Aifryz/usb-pedal/hardware/mini-pill/mini-pill.pdf

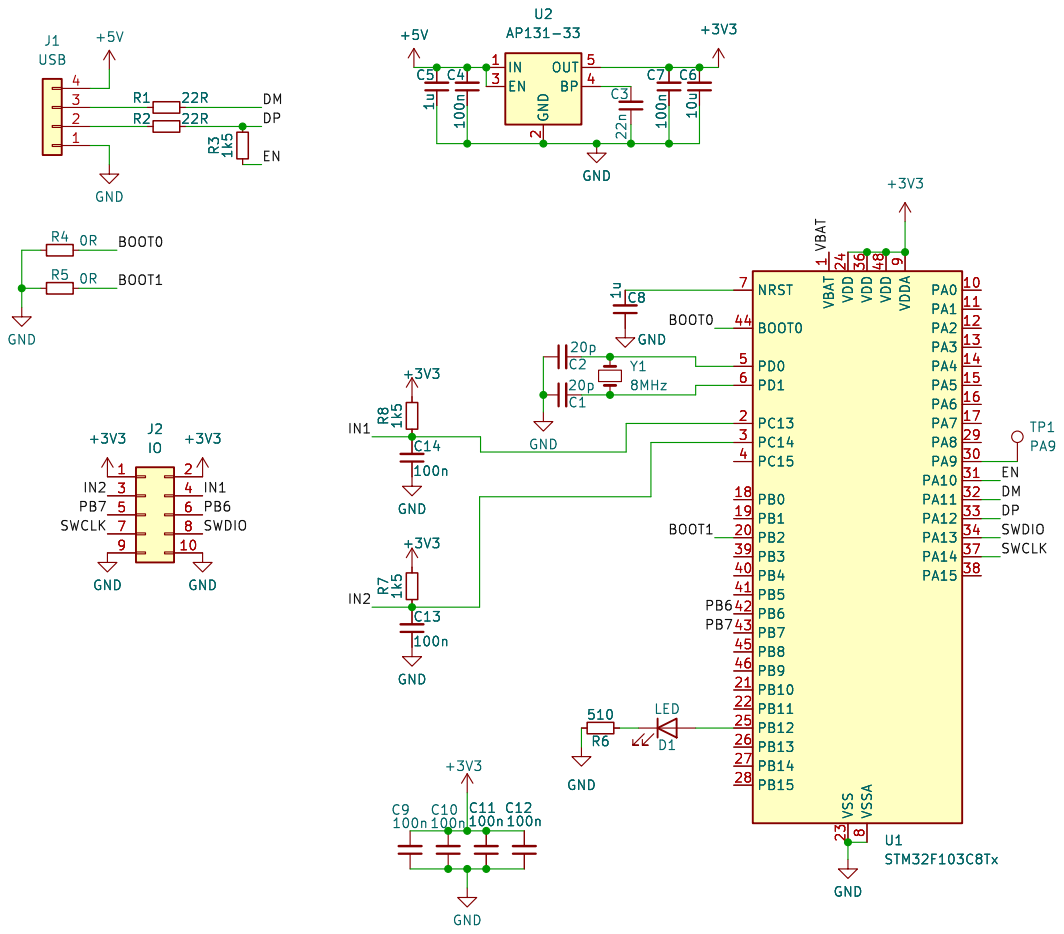
[picture p1: page 1]

Id: 1/1 Title: File: mini-pill.kicad_sch Sheet: / GND GND
