Aifryz/usb-pedal/hardware/mini-pill/mini-pill.kicad_pcb

## KiCad design hardware/mini-pill/mini-pill.kicad_pcb (2023-10-14)

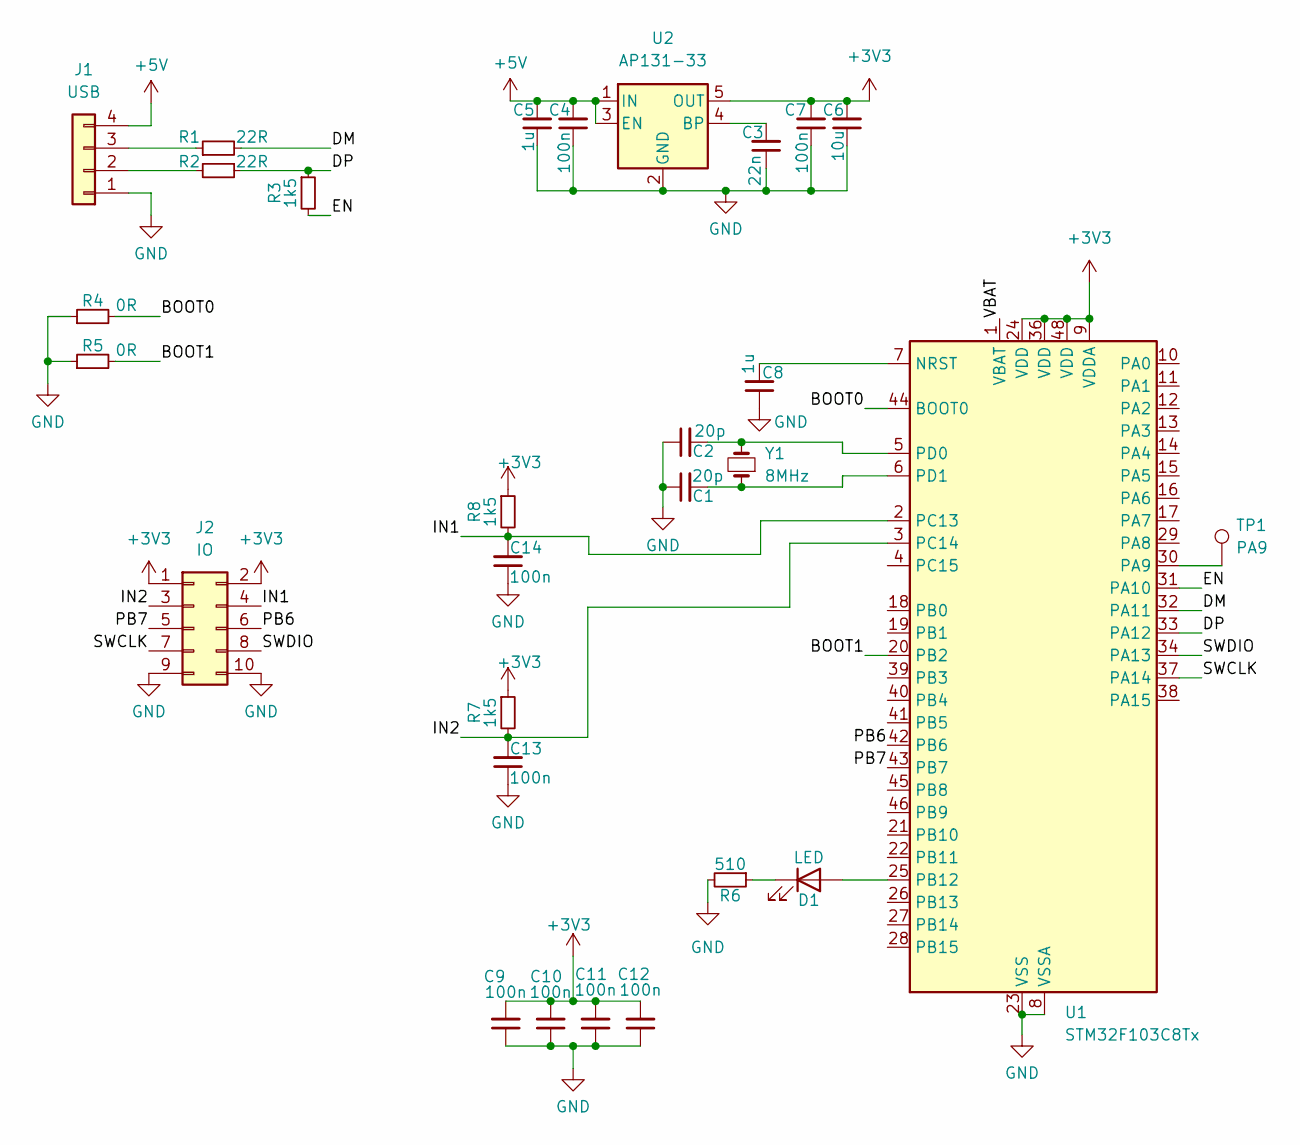
[picture p2: schematic mini-pill.kicad_sch]

Parts:
C1, C2: 20p; C_0603_1608Metric
C3: 22n; C_0603_1608Metric
C4, C7, C9, C10, C11, C12, C13, C14: 100n; C_0603_1608Metric
C5, C8: 1u; C_0603_1608Metric
C6: 10u; C_0805_2012Metric
D1: LED; LED_0805_2012Metric
J1: USB; PinSocket_1x04_P2.00mm_Vertical
J2: IO; PinHeader_2x05_P2.54mm_Vertical
R1, R2: 22R; R_0603_1608Metric
R3, R7, R8: 1k5; R_0603_1608Metric
R4, R5: 0R; R_0603_1608Metric
R6: 510; R_0603_1608Metric
TP1: PA9; TestPoint_Pad_D1.0mm
U1: STM32F103C8Tx; LQFP-48_7x7mm_P0.5mm
U2: AP131-33; SOT-23-5
Y1: 8MHz; Crystal_HC18-U_Vertical

Connections:
+3V3: C6.2, C7.2, C9.2, C10.2, C11.2, C12.2, J2.1, J2.2, R7.1, R8.1, U1.9 (VDDA), U1.24 (VDD), U1.36 (VDD), U1.48 (VDD), U2.5 (OUT)
+5V: C4.2, C5.2, J1.4, U2.1 (IN), U2.3 (EN)
/BOOT0: R4.2, U1.44 (BOOT0)
/BOOT1: R5.2, U1.20 (PB2)
/DM: R1.2, U1.32 (PA11)
/DP: R2.1, R3.1, U1.33 (PA12)
/EN: R3.2, U1.31 (PA10)
/IN1: C14.2, J2.4, R8.2, U1.2 (PC13)
/IN2: C13.2, J2.3, R7.2, U1.3 (PC14)
/PB6: J2.6, U1.42 (PB6)
/PB7: J2.5, U1.43 (PB7)
/SWCLK: J2.7, U1.37 (PA14)
/SWDIO: J2.8, U1.34 (PA13)
/VBAT: U1.1 (VBAT)
GND: C1.1, C2.1, C3.1, C4.1, C5.1, C6.1, C7.1, C8.1, C9.1, C10.1, C11.1, C12.1, C13.1, C14.1, J1.1, J2.9, J2.10, R4.1, R5.1, R6.2, U1.8 (VSSA), U1.23 (VSS), U1.35 (VSS), U1.47 (VSS), U2.2 (GND)
unnamed: D1.2 (A), U1.25 (PB12)
unnamed: D1.1 (K), R6.1
unnamed: J1.2, R2.2
unnamed: J1.3, R1.1
unnamed: C8.2, U1.7 (NRST)
unnamed: TP1.1, U1.30 (PA9)
unnamed: C2.2, U1.5 (PD0), Y1.2
unnamed: C1.2, U1.6 (PD1), Y1.1
unnamed: C3.2, U2.4 (BP)

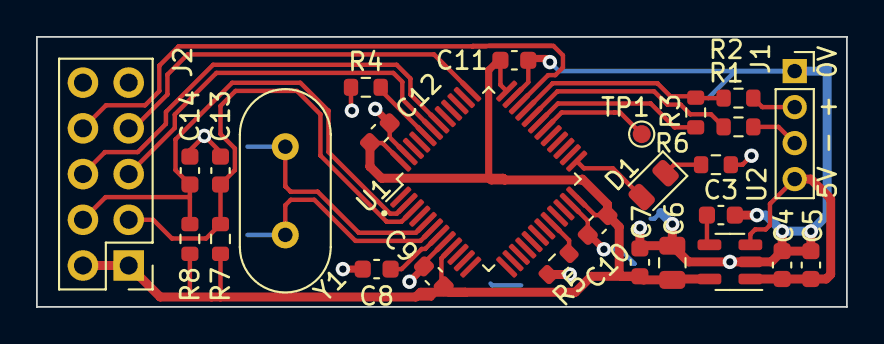
[picture p3: board mini-pill.kicad_pcb from above]

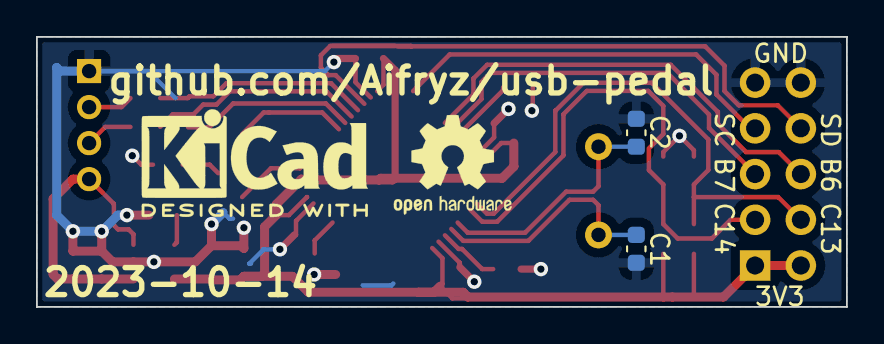
[picture p4: board mini-pill.kicad_pcb from below]

Board: 2 copper layers, 45.0 x 15.0 mm, 29 parts (2 on the bottom side), 23 nets.
