Aifryz/usb-pedal/firmware/usb-pedal/Core/Src/main.c

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
/* Includes ------------------------------------------------------------------*/
#include "main.h"
#include "usb_device.h"

/* USER CODE BEGIN Includes */
#include "usbd_hid.h"
/* USER CODE END Includes */


/* USER CODE BEGIN PV */

const uint8_t KEY_NONE = 0x00;
const uint8_t KEY_APOSTROPHE = 0x34; // Scancode for ' " key

uint8_t hid_report[8];

extern USBD_HandleTypeDef hUsbDeviceFS;
/* USER CODE END PV */

void SystemClock_Config(void);
static void MX_GPIO_Init(void);
/* USER CODE BEGIN PFP */
void MakeReport(uint8_t* report_buf, uint8_t key)
{
	report_buf[2]= key;
}
/* USER CODE END PFP */

/**
  * @brief  The application entry point.
  * @retval int
  */
int main(void)
{
  /* MCU Configuration--------------------------------------------------------*/

  /* Reset of all peripherals, Initializes the Flash interface and the Systick. */
  HAL_Init();

  /* Configure the system clock */
  SystemClock_Config();

  /* Initialize all configured peripherals */
  MX_GPIO_Init();
  MX_USB_DEVICE_Init();
  /* USER CODE BEGIN 2 */
  memset(hid_report, 0, sizeof(hid_report));

  HAL_GPIO_WritePin(USB_EN_GPIO_Port, USB_EN_Pin, SET);
  /* USER CODE END 2 */

  /* Infinite loop */
  /* USER CODE BEGIN WHILE */
  while (1)
  {
    /* USER CODE END WHILE */

    /* USER CODE BEGIN 3 */
	  if(HAL_GPIO_ReadPin(IN1_GPIO_Port, IN1_Pin))
	  {
		  HAL_GPIO_WritePin(LED_GPIO_Port, LED_Pin, SET);
		  MakeReport(hid_report, KEY_NONE);
	  }
	  else
	  {
		  HAL_GPIO_WritePin(LED_GPIO_Port, LED_Pin, RESET);
		  MakeReport(hid_report, KEY_APOSTROPHE);
	  }

	  USBD_HID_SendReport(&hUsbDeviceFS,  hid_report, sizeof(hid_report));
	  HAL_Delay(5);
  }
  /* USER CODE END 3 */
}

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
