Aifryz/usb-pedal/firmware/usb-pedal/usb-pedal.ioc

Mcu.UserName=STM32F103C8Tx
PA10.GPIO_Label=USB_EN
PA10.Signal=GPIO_Output
PA11.Signal=USB_DM
PA12.Signal=USB_DP
PA13.Signal=SYS_JTMS-SWDIO
PA14.Signal=SYS_JTCK-SWCLK
PB12.GPIO_Label=LED
PB12.Signal=GPIO_Output
PB6.Signal=GPIO_Input
PB7.Signal=GPIO_Input
PC13-TAMPER-RTC.GPIO_Label=IN1
PC13-TAMPER-RTC.Signal=GPIO_Input
PC14-OSC32_IN.GPIO_Label=IN2
PC14-OSC32_IN.Signal=GPIO_Input
PD0-OSC_IN.Signal=RCC_OSC_IN
PD1-OSC_OUT.Signal=RCC_OSC_OUT
