Aifryz/usb-pedal/(commit log)

2023-10-12 Add pcb
    [mini-pill.kicad_pcb, mini-pill.kicad_sch]
2023-10-14 Add schematic
    [mini-pill.kicad_pcb, mini-pill.kicad_sch]
